VitorMendesC/Prototipo-Instrumento-Dentista/(list of files, drawings)

Other design files:
Bridge simulation/H.pdsprj
