VitorMendesC/Prototipo-Instrumento-Dentista/CubeIDE Workspace/Bak/main_tudo.c

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
/* Includes ------------------------------------------------------------------*/
#include "main.h"

/* USER CODE BEGIN Includes */
#include "lcd.h"
#include <math.h>
#include <stdlib.h>
#include <stdio.h>
/* USER CODE END Includes */

/* USER CODE BEGIN PD */
#define HORARIO 1
#define ANTIHORARIO -1
#define ADC_MAX_THR 4010		// Valor do ADC a partir do qual é considerao 100% do pedal (max = 4095)
#define ADC_MIN_THR 100			// Valor do ADC a partir do qual é considerao 0 do pedal
#define RPM_LOW_THR	100			// Valor menor que esse, motor considerado muito lento/parado
#define RPM_TIME_DELAY 300		// Intervalo de tempo entre checagens na velocidade, identifica motor parado
#define LCD_TIME_DELAY 200		// Intervalo de tempo entre atualizações do LCD
#define ADC_TIME_DELAY 300		// Intervalo de tempo usado para identificar variações rápidas no pedal
#define MAX_ADC_VARIATION 400	// Define a variação máxima permitida do ADC em um itervalo de tempo
#define NOISE 300				// Adiciona robustez a rudios na leitura do ADC
#define PPR 1000
#define TIM4_FREQ 40
/* USER CODE END PD */

ADC_HandleTypeDef hadc1;
DMA_HandleTypeDef hdma_adc1;

TIM_HandleTypeDef htim1;
TIM_HandleTypeDef htim3;
TIM_HandleTypeDef htim4;

void SystemClock_Config(void);
static void MX_GPIO_Init(void);
static void MX_DMA_Init(void);
static void MX_ADC1_Init(void);
static void MX_TIM1_Init(void);
static void MX_TIM3_Init(void);
static void MX_TIM4_Init(void);
/* USER CODE BEGIN 0 */
uint32_t current_time;				// Armazena o tempo atual
uint32_t last_time_RPM;				// Armazena o ultimo instante em que a RPM foi checada
uint32_t last_time_ADC;				// Armazena o ultimo instante em que o valor do ADC foi checado
uint32_t last_time_LCD;				// Armazena o ultimo tempo em que o LCD foi atualizado
uint32_t ADC_atual;
uint32_t ADC_anterior = 0;
uint32_t maior_valor = 0;			// Maior valor que foi atingido pelo ADC
uint16_t ticks;
float RPM;
float duty_cycle;
int conversion;						// Valor da conversão do ADC para parametros do PWM
int count;							// Conta quantas vezes o pedal foi acionado até fim de curso
int sentido_giro = HORARIO;
int en_increment, en_count;			// flag que habilita incremento na velocidade e contagem de fim de curso
int motor_low_speed_flag = 0;		// Alta caso motor lento <100 RPM
int safety_flag = 0;				// Alta caso algo de errado: movimento rapido no pedal ou motor travado
int motor_lock_flag = 0;			// Alta caso motor travado
int fast_movment_flag = 1	;			// Alta caso movimento rapido no pedal, começa em alta para forçar retorno do pedal
int n_medidas = 25;					// Numero de medidas para realização da media do ADC
int total = 0;						// Total da soma dos valores do ADC
/* USER CODE END 0 */

/**
  * @brief  The application entry point.
  * @retval int
  */
int main(void)
{
  /* MCU Configuration--------------------------------------------------------*/

  /* Reset of all peripherals, Initializes the Flash interface and the Systick. */
  HAL_Init();

  /* Configure the system clock */
  SystemClock_Config();

  /* Initialize all configured peripherals */
  MX_GPIO_Init();
  MX_DMA_Init();
  MX_ADC1_Init();
  MX_TIM1_Init();
  MX_TIM3_Init();
  MX_TIM4_Init();
  /* USER CODE BEGIN 2 */
  lcd_Init(GPIOA, GPIO_PIN_4, GPIO_PIN_5,
		  GPIO_PIN_6, GPIOB, GPIO_PIN_12,
		  GPIO_PIN_13, GPIO_PIN_14, GPIO_PIN_15);
  HAL_TIM_Base_Start(&htim3);
  HAL_TIM_Base_Start_IT(&htim4);
  HAL_TIM_PWM_Start(&htim1, TIM_CHANNEL_1);
  HAL_TIM_PWM_Start(&htim1, TIM_CHANNEL_2);
  HAL_ADCEx_Calibration_Start(&hadc1);
  last_time_LCD = HAL_GetTick();
  last_time_ADC = HAL_GetTick();
  /* USER CODE END 2 */

  /* Infinite loop */
  /* USER CODE BEGIN WHILE */
  while (1)
  {
	  current_time = HAL_GetTick();

	  //HAL_ADC_Start(&hadc1);
	  //HAL_ADC_PollForConversion(&hadc1, 20);			// Espera pelo resultado por até 20 ms
	  //ADC_atual = HAL_ADC_GetValue(&hadc1);				// le o valor do potenciometro

	  total = 0;
	  for(int i=0;i<n_medidas;i++) {					// Coleta 25 leituras do ADC
		  HAL_ADC_Start(&hadc1);
		  HAL_ADC_PollForConversion(&hadc1, HAL_MAX_DELAY);
		  uint16_t adc_value = HAL_ADC_GetValue(&hadc1);
		  total += adc_value;
	  }

	  ADC_atual = total/n_medidas;						// Faz a média das leituras do ADC, evitando ruidos

	  RPM = ticks*TIM4_FREQ*60/(PPR*0.6);

	  if(RPM < RPM_LOW_THR && !motor_low_speed_flag){	// Se o motor estiver lento e a flag de motor
		  motor_low_speed_flag = 1;						// lento ainda não foi acionada
		  last_time_RPM = current_time;					// aciona a flag e o timer para nova checagem
	  }

	  if(current_time - last_time_RPM > RPM_TIME_DELAY && motor_low_speed_flag){
		  if(RPM < RPM_LOW_THR){
			  safety_flag = 1;
			  motor_lock_flag = 1;						// Se o motor não se mover depois de RPM_TIME_DELAY ms
		  }												// considera-se motor travado
		  else{
			  motor_low_speed_flag = 0;					// Motor entrou em movimento, operação normal
		  }
	  }

	  if(current_time - last_time_ADC > ADC_TIME_DELAY){
		  if((int) (abs(ADC_atual - ADC_anterior)) > MAX_ADC_VARIATION){
			  safety_flag = 1;							// compara o variação do ADC com um valor maximo excolhio
			  fast_movment_flag = 1;					// dentro de uma janela de tempo, se maior, movimento rapido
		  }												// detectado, liga-se as flag de segurança e movimento rapido
		  ADC_anterior = ADC_atual;
		  last_time_ADC = current_time;
	  }

	  if(safety_flag){									// Caso haja um problema de segurança, encerra a operação do
		  htim1.Instance->CCR2=0;						// motor, desligando os PWM e ENABLE
		  htim1.Instance->CCR1=0;
		  HAL_Delay(20);
		  HAL_GPIO_WritePin(en1_GPIO_Port, en1_Pin, GPIO_PIN_SET);
		  HAL_GPIO_WritePin(en2_GPIO_Port, en2_Pin, GPIO_PIN_SET);
		  duty_cycle = 0.;
	  }

	  if(ADC_atual < ADC_MIN_THR - NOISE){						// Caso pedal volte pra posição inicial
		  en_increment = 1;										// habilita-se o enable do incremento
		  safety_flag = 0;										// e reseta as flags
		  motor_lock_flag = 0;
		  fast_movment_flag = 0;
	  }

	  if(ADC_atual < ADC_MAX_THR - NOISE && !safety_flag){		// Caso o pedal seja recuado para baixo
		  en_count = 1;											// do treshold de maximae nã haja problemas de
	  }															// segurançá, permite-se o incremento da
	  	  	  	  	  	  	  	  	  	  	  	  	  	  	  	// contagem de fim de curso

	  if(ADC_atual > ADC_MAX_THR && en_count && !safety_flag){	// Conta quantas vezes o pedal foi pressionado
		  count = count + 1;									// até o fim de curso, caso não haja problemas de
		  en_count = 0;											// segurança
	  }


	  if((ADC_atual > maior_valor || (en_increment && ADC_atual > ADC_MIN_THR + NOISE)) && !safety_flag){
		  maior_valor = ADC_atual;								// Caso a leitura do ADC for maior que o valor maximo
		  en_increment = 0;										// registrado, aumenta-se o ciclo de trabalho

		  conversion = (int) (maior_valor/40.96);				// Caso o ADC não seja maior que o máximo, mas o pedal
		  duty_cycle = conversion;								// foi retornado a posição inicial, e o valor do ADC
		  if(sentido_giro == HORARIO){							// é maior do que o threshold inferior, o ciclo de
			  htim1.Instance->CCR1=conversion;					// trabalho é atualizado para o novo valor
			  htim1.Instance->CCR2=0;
		  }
		  if(sentido_giro == ANTIHORARIO){						// Tais casos só executam se não hover problema de
			  htim1.Instance->CCR1=0;							// segurançá
			  htim1.Instance->CCR2=conversion;
		  }
	  }

	  if(count>=2){												// Inverte o sentido de rotação depois de desligar
		  htim1.Instance->CCR1=0;								// os ENALBE e PWM
		  htim1.Instance->CCR2=0;
		  HAL_Delay(1000);
		  HAL_GPIO_WritePin(en1_GPIO_Port, en1_Pin, GPIO_PIN_SET);
		  HAL_GPIO_WritePin(en2_GPIO_Port, en2_Pin, GPIO_PIN_SET);
		  HAL_Delay(1000);
		  count = 0;
		  sentido_giro=sentido_giro * -1;
	  }

	  if(sentido_giro == HORARIO && !safety_flag){			// liga os enables de acordo com o sentido de rotação
		  HAL_GPIO_WritePin(en1_GPIO_Port, en1_Pin, GPIO_PIN_SET);
		  HAL_GPIO_WritePin(en2_GPIO_Port, en2_Pin, GPIO_PIN_RESET);
	  }

	  if(sentido_giro == ANTIHORARIO && !safety_flag){		// liga os enables de acordo com o sentido de rotação
		  HAL_GPIO_WritePin(en1_GPIO_Port, en1_Pin, GPIO_PIN_RESET);
		  HAL_GPIO_WritePin(en2_GPIO_Port, en2_Pin, GPIO_PIN_SET);
	  }

	  if(current_time - last_time_LCD > LCD_TIME_DELAY){	// Atualiza o display a cada LCD_TIME_DELAY ms
		  lcd_clear();
		  if(motor_lock_flag){
			  lcd_gotoxy(0,0);
			  lcd_printf("MOTOR TRAVADO");
			  lcd_gotoxy(0,1);
			  lcd_printf("Retorne a inicio");
		  }
		  else if(fast_movment_flag){
			  lcd_gotoxy(0,0);
			  lcd_printf("MOVIMENTO RAPIDO");
			  lcd_gotoxy(0,1);
			  lcd_printf("Retorne a inicio");
		  }
		  else{
			  lcd_gotoxy(0,0);
			  lcd_printf("(%c) RPM: %0.0f ", (sentido_giro==1) ? 'H':'A' , RPM); // Mostra o sentido de giro e a RPM
			  lcd_gotoxy(0,1);
			  lcd_printf("Ciclo T.: %0.1f %%", duty_cycle);
		  }
		  last_time_LCD = HAL_GetTick();
	  }
    /* USER CODE END WHILE */

    /* USER CODE BEGIN 3 */
  }
  /* USER CODE END 3 */
}

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
