VitorMendesC/Prototipo-Instrumento-Dentista/CubeIDE Workspace/Core/Inc/main.h

#define en1_Pin GPIO_PIN_5
#define en1_GPIO_Port GPIOB
#define en2_Pin GPIO_PIN_6
#define en2_GPIO_Port GPIOB
