VitorMendesC/Prototipo-Instrumento-Dentista/img/ponte.jpg

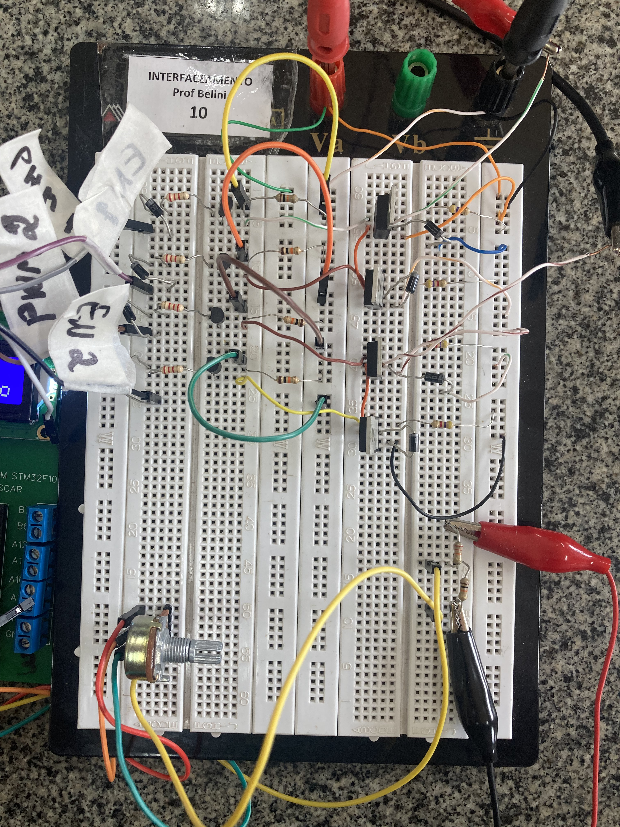
[picture p2: img/ponte.jpg]
img/ponte.jpg
